iXimik/iTime/docs/wiring.md

# Подключение 16-пинового LCD 1602 к ESP-WROOM-32

Проверенный дисплей: **Winstar WH1602A-YGH-CT(K)**, символьный ЖКИ 16×2, интерфейс **parallel**. На испытаниях использовался 4-битный режим, синяя подсветка, отдельный потенциометр контраста и макетная плата.

## Таблица соединений

| Номер | Маркировка LCD | Подключение / назначение |
|---:|---|---|
| 1 | VSS | GND |
| 2 | VDD | +5 V |
| 3 | VO | Регулировка контраста, ползунок потенциометра |
| 4 | RS | GPIO16 (RX2), 3,3→5 В согласователь |
| 5 | RW | GND (только запись) |
| 6 | E | GPIO17 (TX2), согласователь |
| 7 | D0 | не используется |
| 8 | D1 | не используется |
| 9 | D2 | не используется |
| 10 | D3 | не используется |
| 11 | D4 | GPIO18, согласователь |
| 12 | D5 | GPIO19, согласователь |
| 13 | D6 | GPIO21, согласователь |
| 14 | D7 | GPIO22, согласователь |
| 15 | A | Плюс LED-подсветки через резистор, согласовать ток |
| 16 | K | GND подсветки |

Соответствующая строка исходника:

~~~cpp
LiquidCrystal lcd(16, 17, 18, 19, 21, 22);
~~~

**Нюансы питания и уровней**

ESP32 GPIO работает на **3,3 В**. Дисплей может питаться от **5 В**, но допустимые уровни входов зависят от точной версии LCD-контроллера. Для гарантированной совместимости используйте **74HCT245** (один 8-канальный буфер) или **две микросхемы 74HCT125** (четыре канала на каждой). У этих микросхем при питании 5 В входные пороги TTL-совместимы с 3,3-вольтовыми выходами ESP32; обязательно настроить направление и разрешение выходов согласно datasheet. Обычную **74HC** без буквы T нельзя автоматически считать равноценной.

Контраст: потенциометр **10 кОм** между 5 В и GND, движок к VO. Подсветка: в прототипе применён стартовый резистор **330 Ом** между 5 В и выводом A; требуемый ток зависит от паспорта конкретного модуля. Без проверки не подключайте LED+ напрямую к 5 В.

Монтаж: **сначала снять USB-питание**, затем переставлять провода. Все цепи должны иметь общую землю. Не подавайте 5 В непосредственно на GPIO ESP32. Не замыкайте цепи макетной платы.

## Как диагностировать «один ряд прямоугольников»

У LCD 1602 первая строка из заполненных клеток при пустой второй — типичный признак поданного питания, но отсутствующей корректной инициализации (либо сбоя линий E/RS/D4..D7), а не автоматически «битого экрана». Проверить:
1. Контраст VO, питание VSS/VDD.
2. RS→GPIO16, E→GPIO17, D4→GPIO18, D5→GPIO19, D6→GPIO21, D7→GPIO22.
3. RW точно GND.
4. Успешную загрузку прошивки в ESP32.
5. Совместимость уровней сигналов.

## Испытанное железо и фото

Фото общего стенда и платы описаны в [photos.md](photos.md). Макетная проводка на фотографиях — исторический прототип, не готовая сертифицированная схема.
