iXimik/iTime/firmware/itime_2_1/openweather_ca.h

#pragma once
// Public root CA certificates: ISRG Root X1, ISRG Root X2, USERTrust RSA.
// This PEM list is parsed by mbedTLS and used for normal TLS verification.
// Hostname verification and expiration checks remain enabled.
// Trust-store contents may need updating if OpenWeather rotates to a different CA.
static const char OPENWEATHER_ROOT_CA[] = R"CERT(
-----BEGIN CERTIFICATE-----
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
-----END CERTIFICATE-----
-----BEGIN CERTIFICATE-----
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
/q4AaOeMSQ+2b1tbFfLn
-----END CERTIFICATE-----
-----BEGIN CERTIFICATE-----
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
jjxDah2nGN59PRbxYvnKkKj9
-----END CERTIFICATE-----
)CERT";
