iXimik/iTime/firmware/itime_2_1/secrets.example.h

#pragma once
// Copy these three settings into your existing secrets.h.
// Never commit secrets.h. Rotate previously exposed OpenWeather API keys.
#define WIFI_SSID "your_wifi_2_4ghz"
#define WIFI_PASSWORD "your_password"
#define OPENWEATHER_API_KEY "your_new_openweather_key"
