iXimik/iTime/(commit log)

2026-10-30 feat: publish iTime ESP32 NTP clock, 40 MHz flash diagnostics and docs
2026-10-30 docs: embed six real ESP32 prototype photos in README gallery
2026-11-04 docs: Russian iTime 2.1 stable guide with wiring, weather and sarcastic troubleshooting
2026-11-04 fix(itime-2.1): restore exact stable CA bundle byte-for-byte
    [openweather_ca.h]
